SadCat1233/Laser-Space-Communication/Electrical Schemes/Station.jpeg

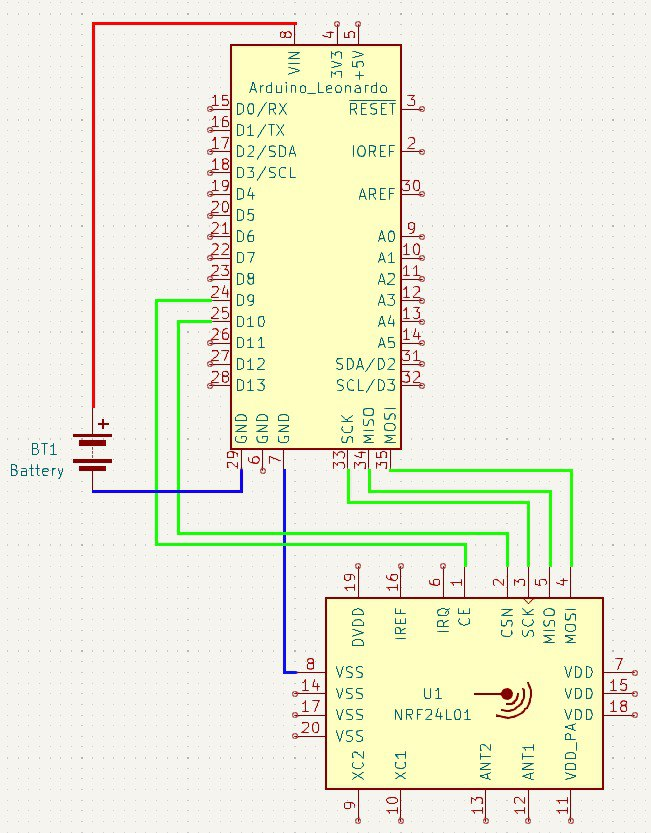
Electrical Schemes/Station.jpeg
