SadCat1233/Laser-Space-Communication/Electrical Schemes/Cubsat №2.jpeg

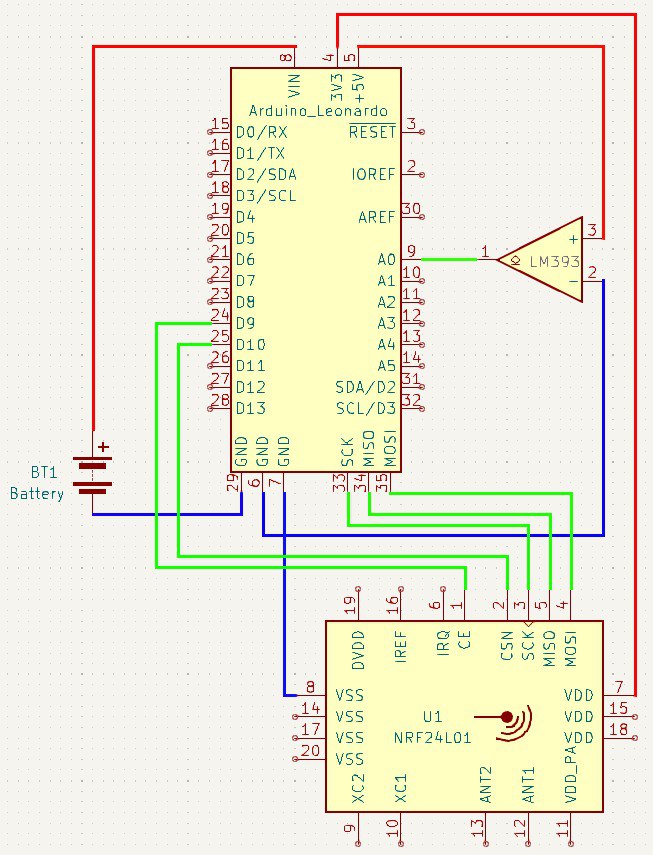
Electrical Schemes/Cubsat №2.jpeg
