SadCat1233/Laser-Space-Communication/Models/Cubsat.stl

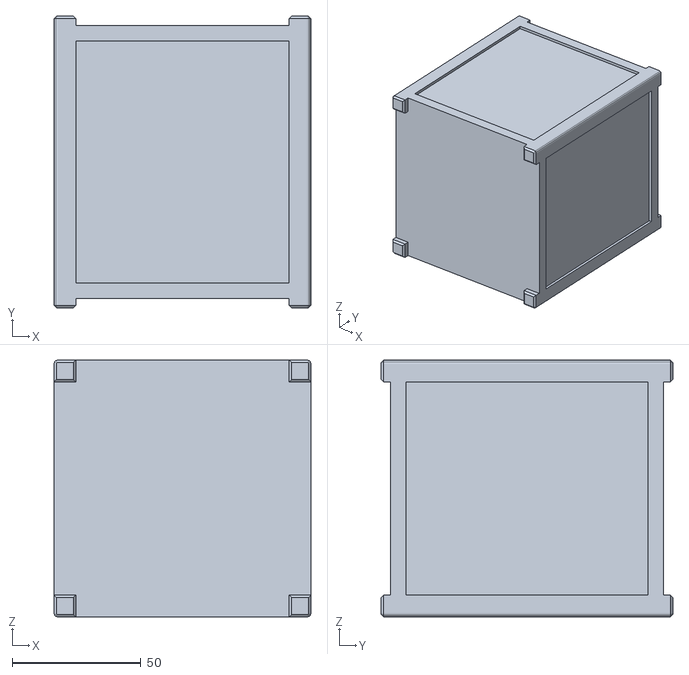
[picture p18: CAD file, 2024-02-10]
Models/Cubsat.stl
100.0 x 113.5 x 100.0
