SadCat1233/Laser-Space-Communication/Models/Рельса под 6мм.stl

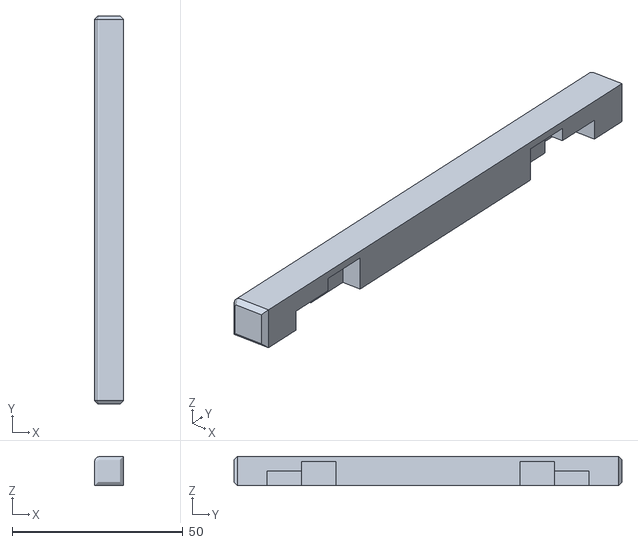
[picture p19: CAD file, 2024-02-10]
Models/Рельса под 6мм.stl
8.50 x 113.5 x 8.50
