SadCat1233/Laser-Space-Communication/Models/Крышка.dxf

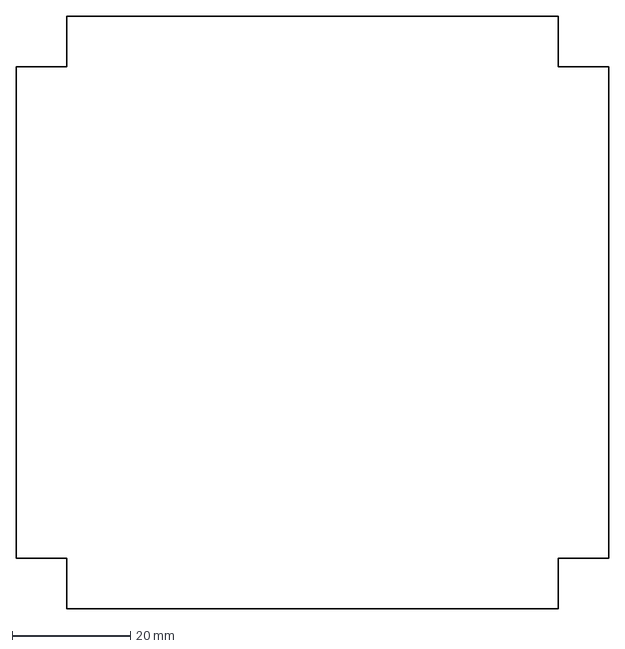
[picture p20: CAD file, 2024-02-10]
Models/Крышка.dxf
100.0 x 100.0 mm
