SadCat1233/Laser-Space-Communication/Models/Стенка.dxf

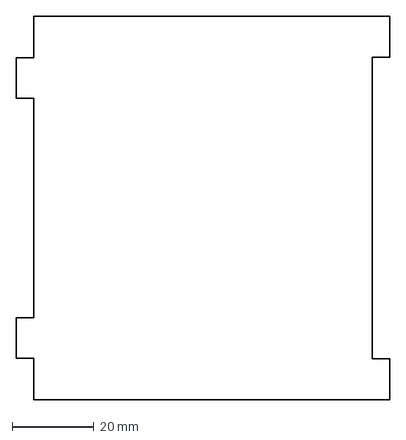
[picture p21: CAD file, 2024-02-10]
Models/Стенка.dxf
91.6 x 94.0 mm
