SadCat1233/Laser-Space-Communication/Drawings/1.pdf

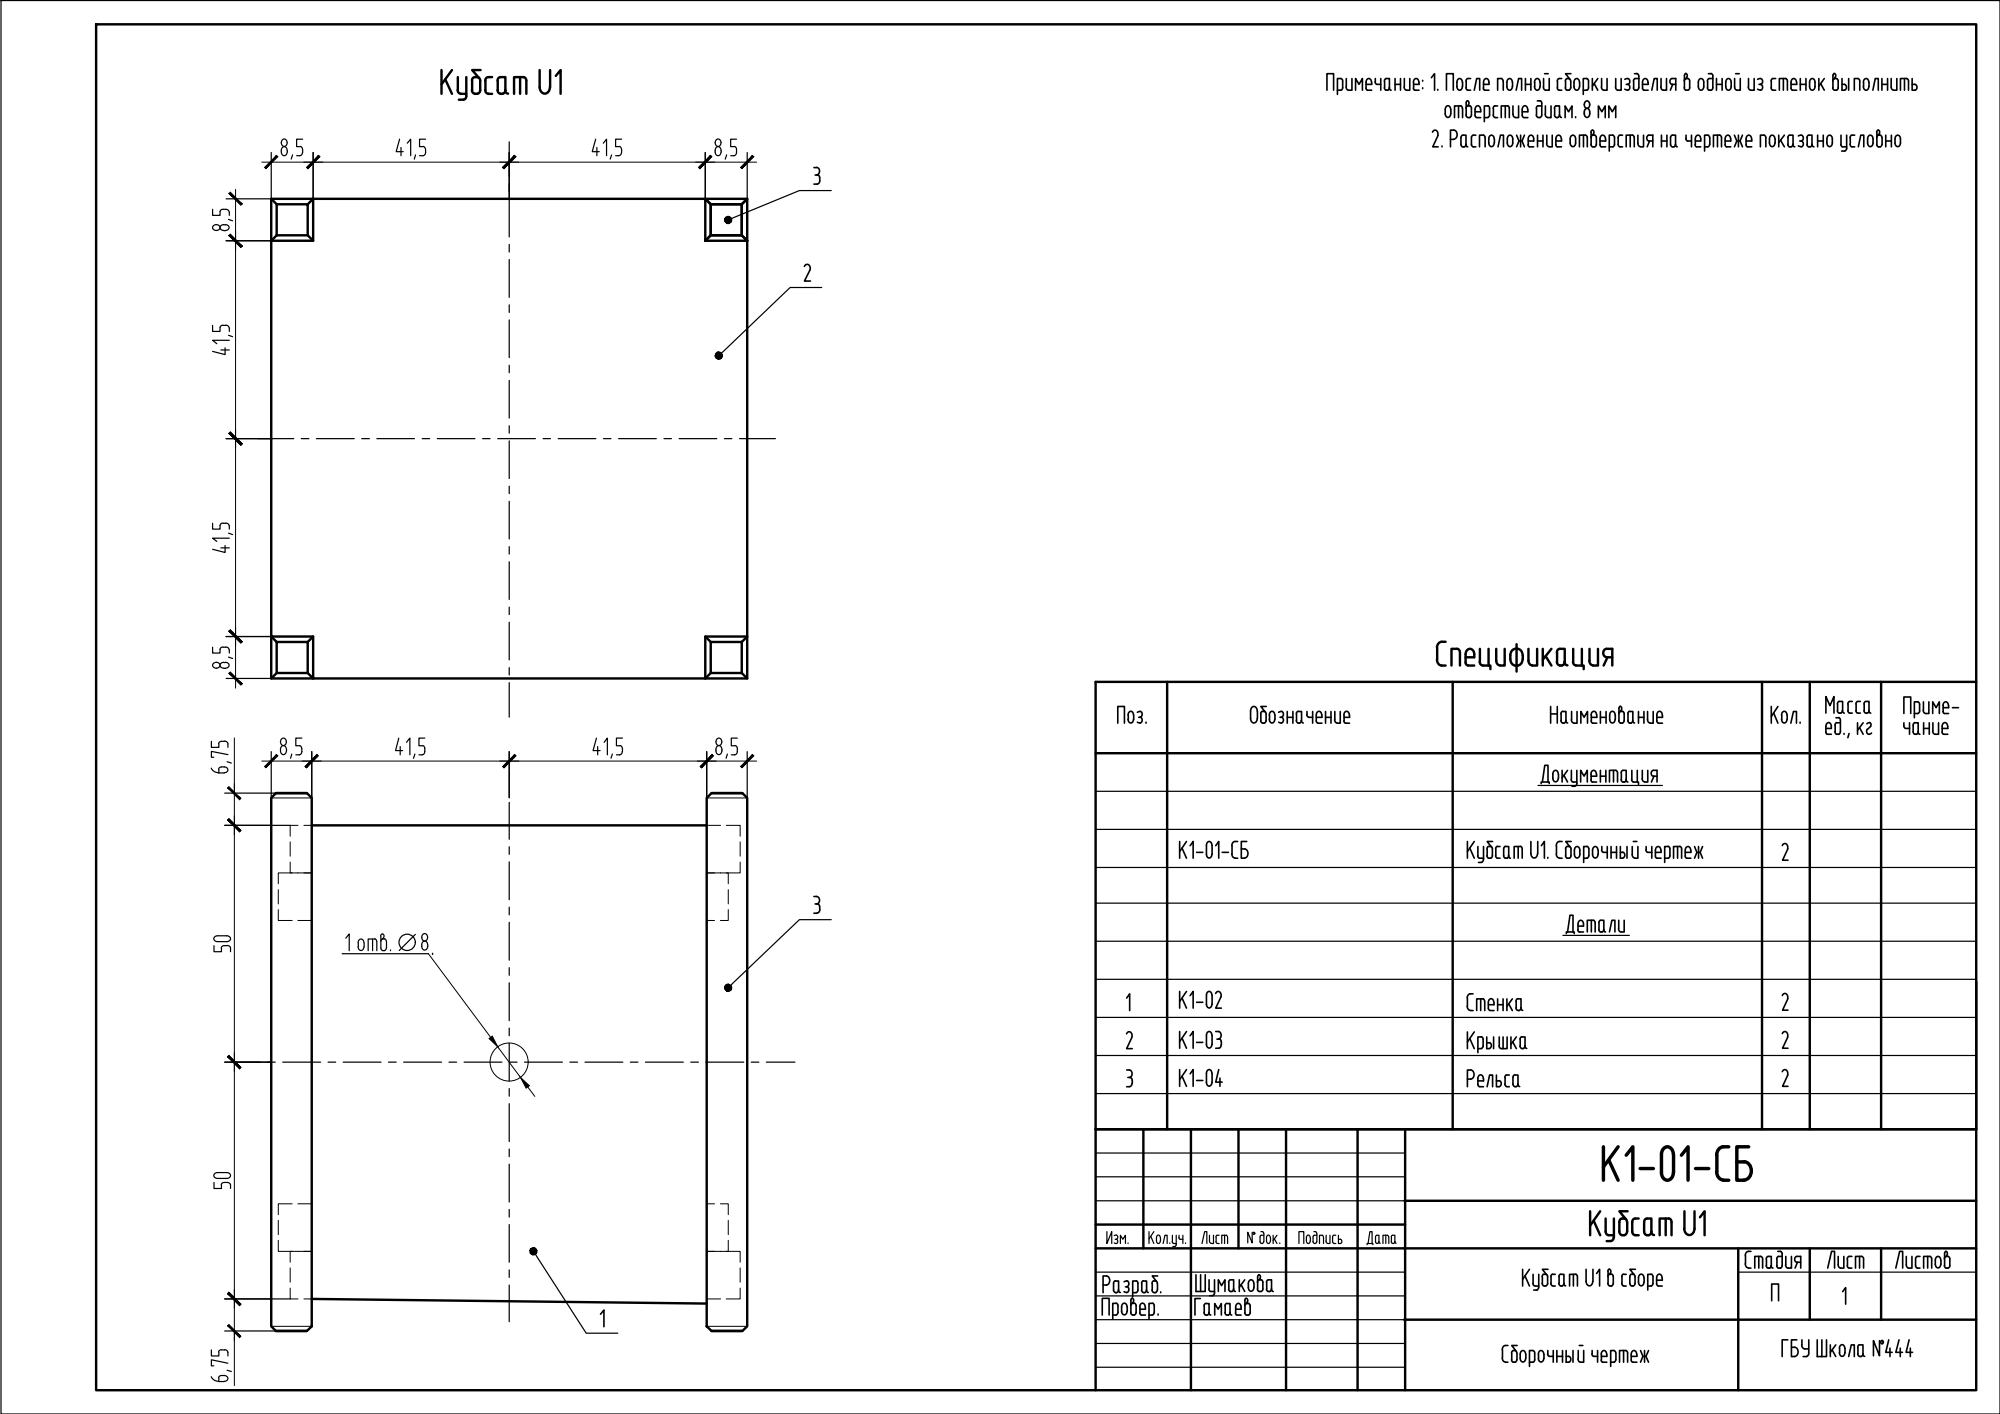
[picture p22: page 1]
