SadCat1233/Laser-Space-Communication/Drawings/2.pdf

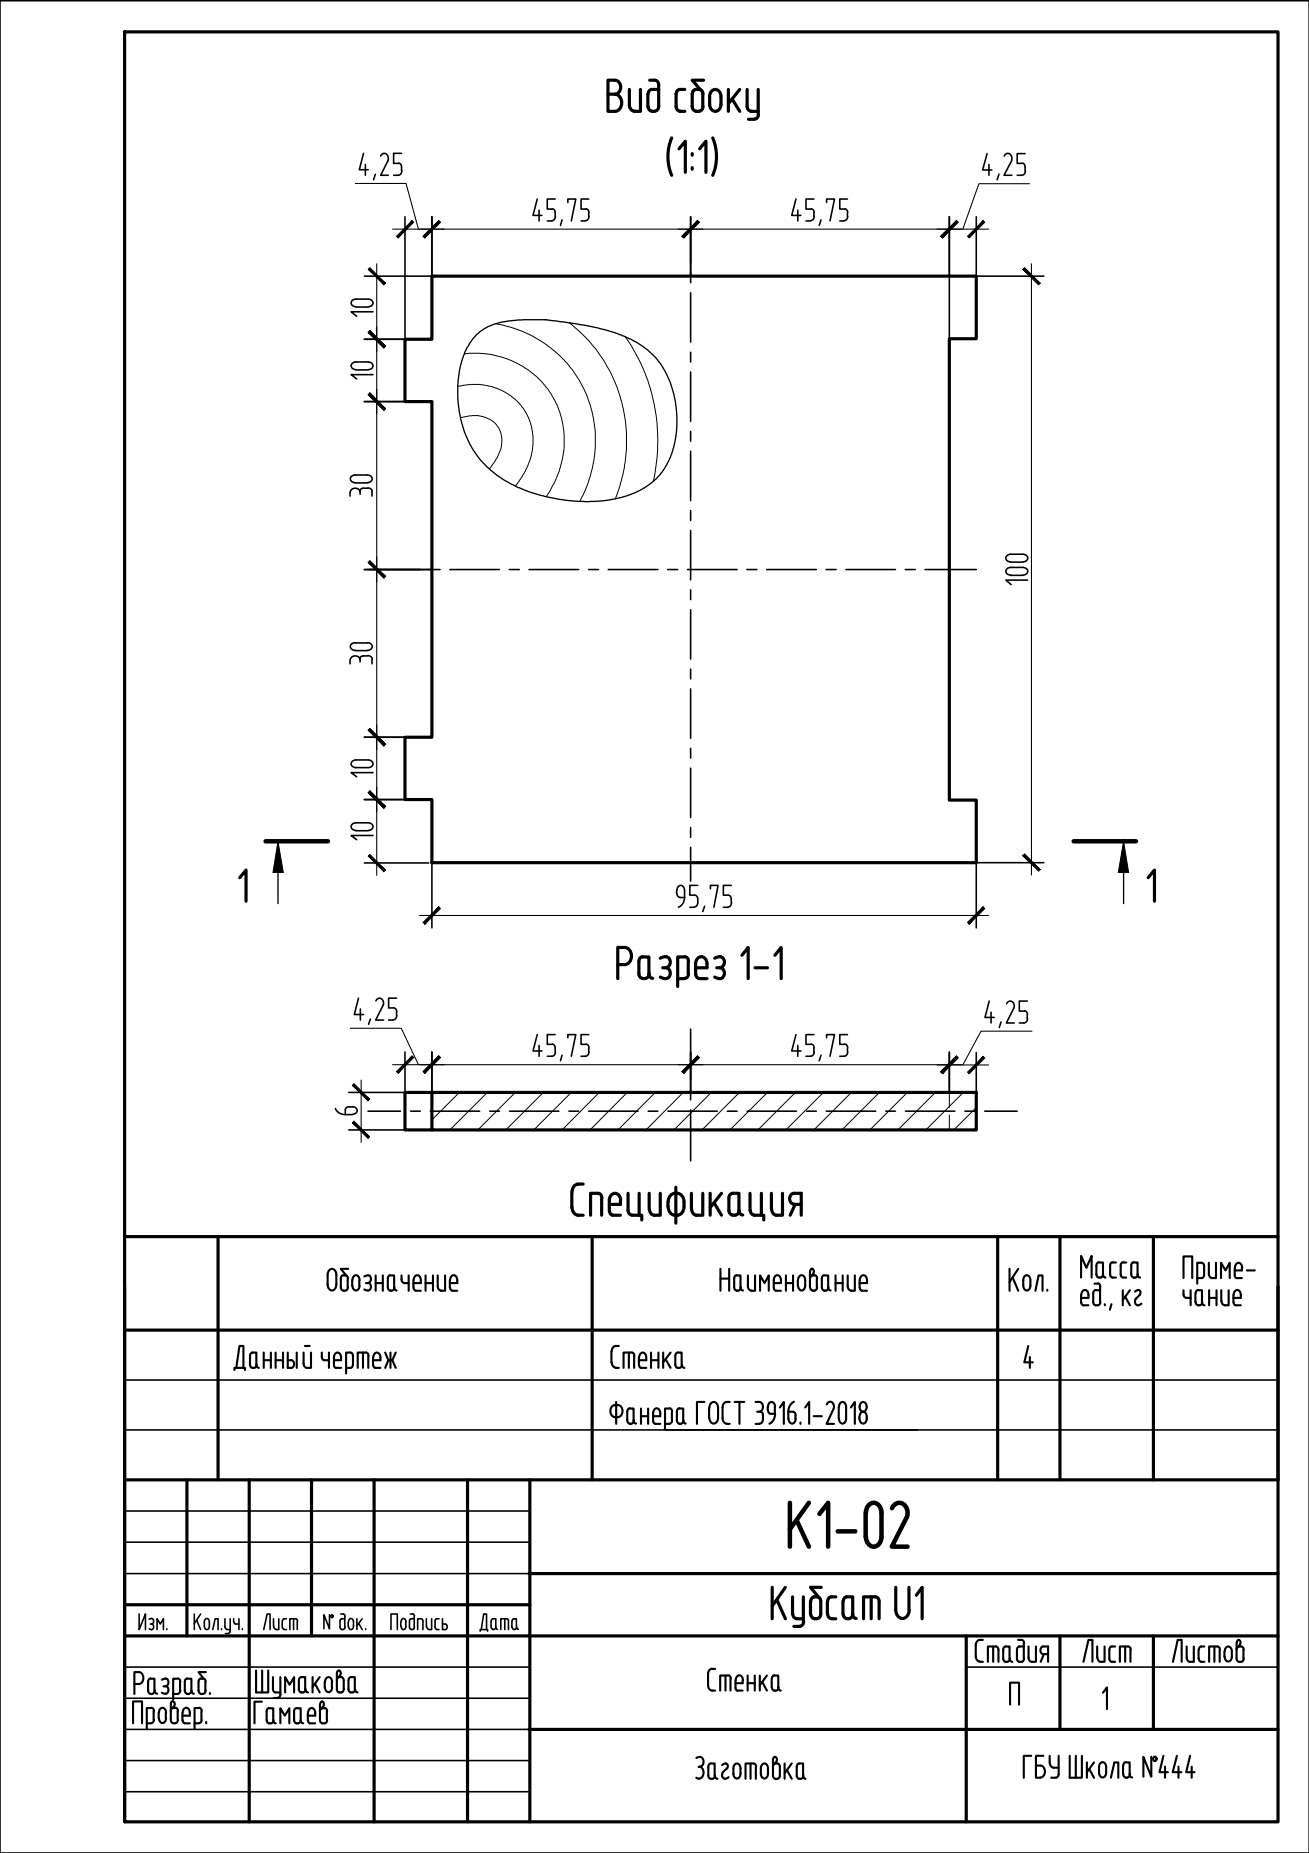
[picture p23: page 1]
