SadCat1233/Laser-Space-Communication/Drawings/3.pdf

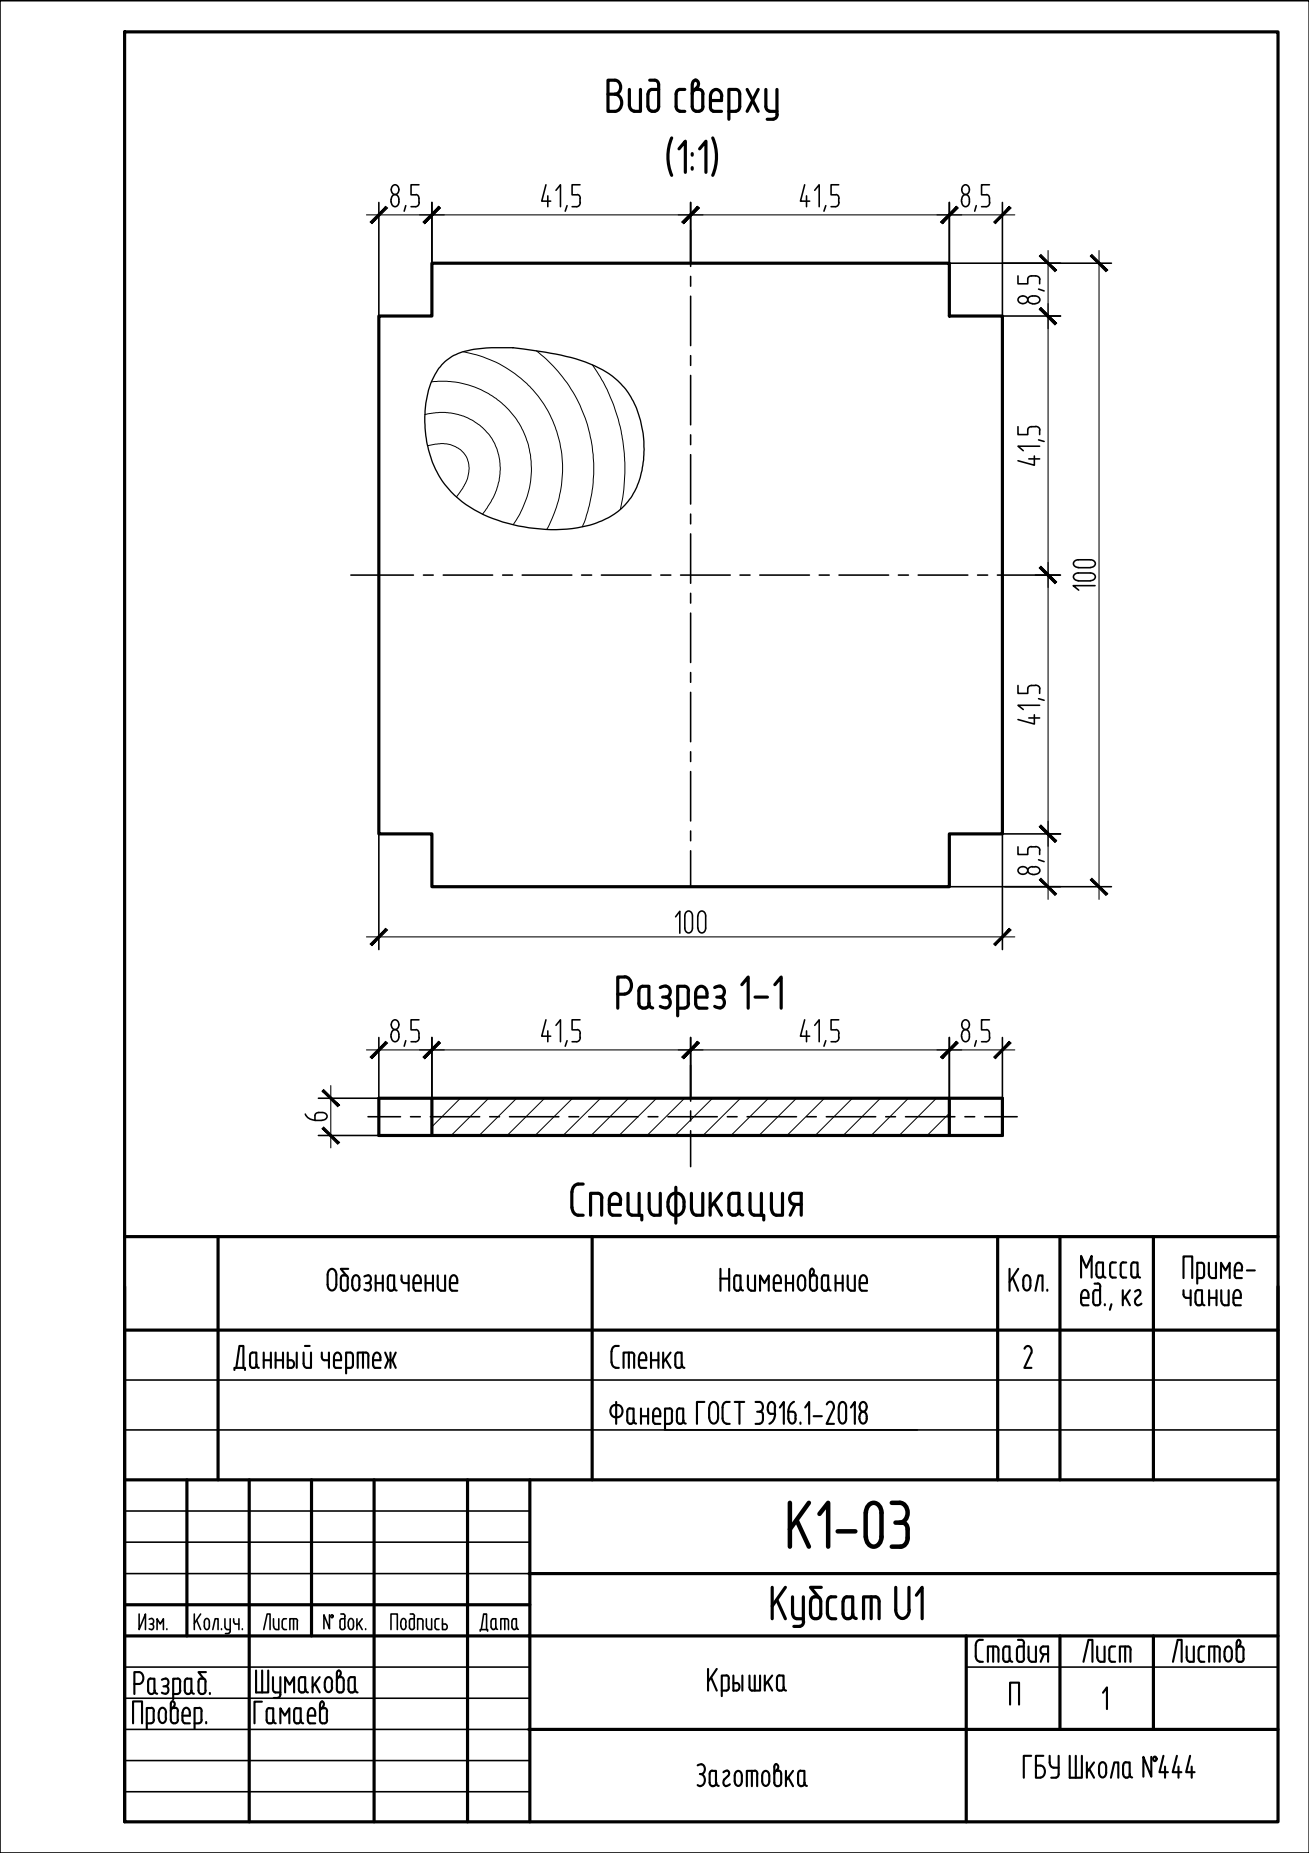
[picture p24: page 1]
