SadCat1233/Laser-Space-Communication/Drawings/4.pdf

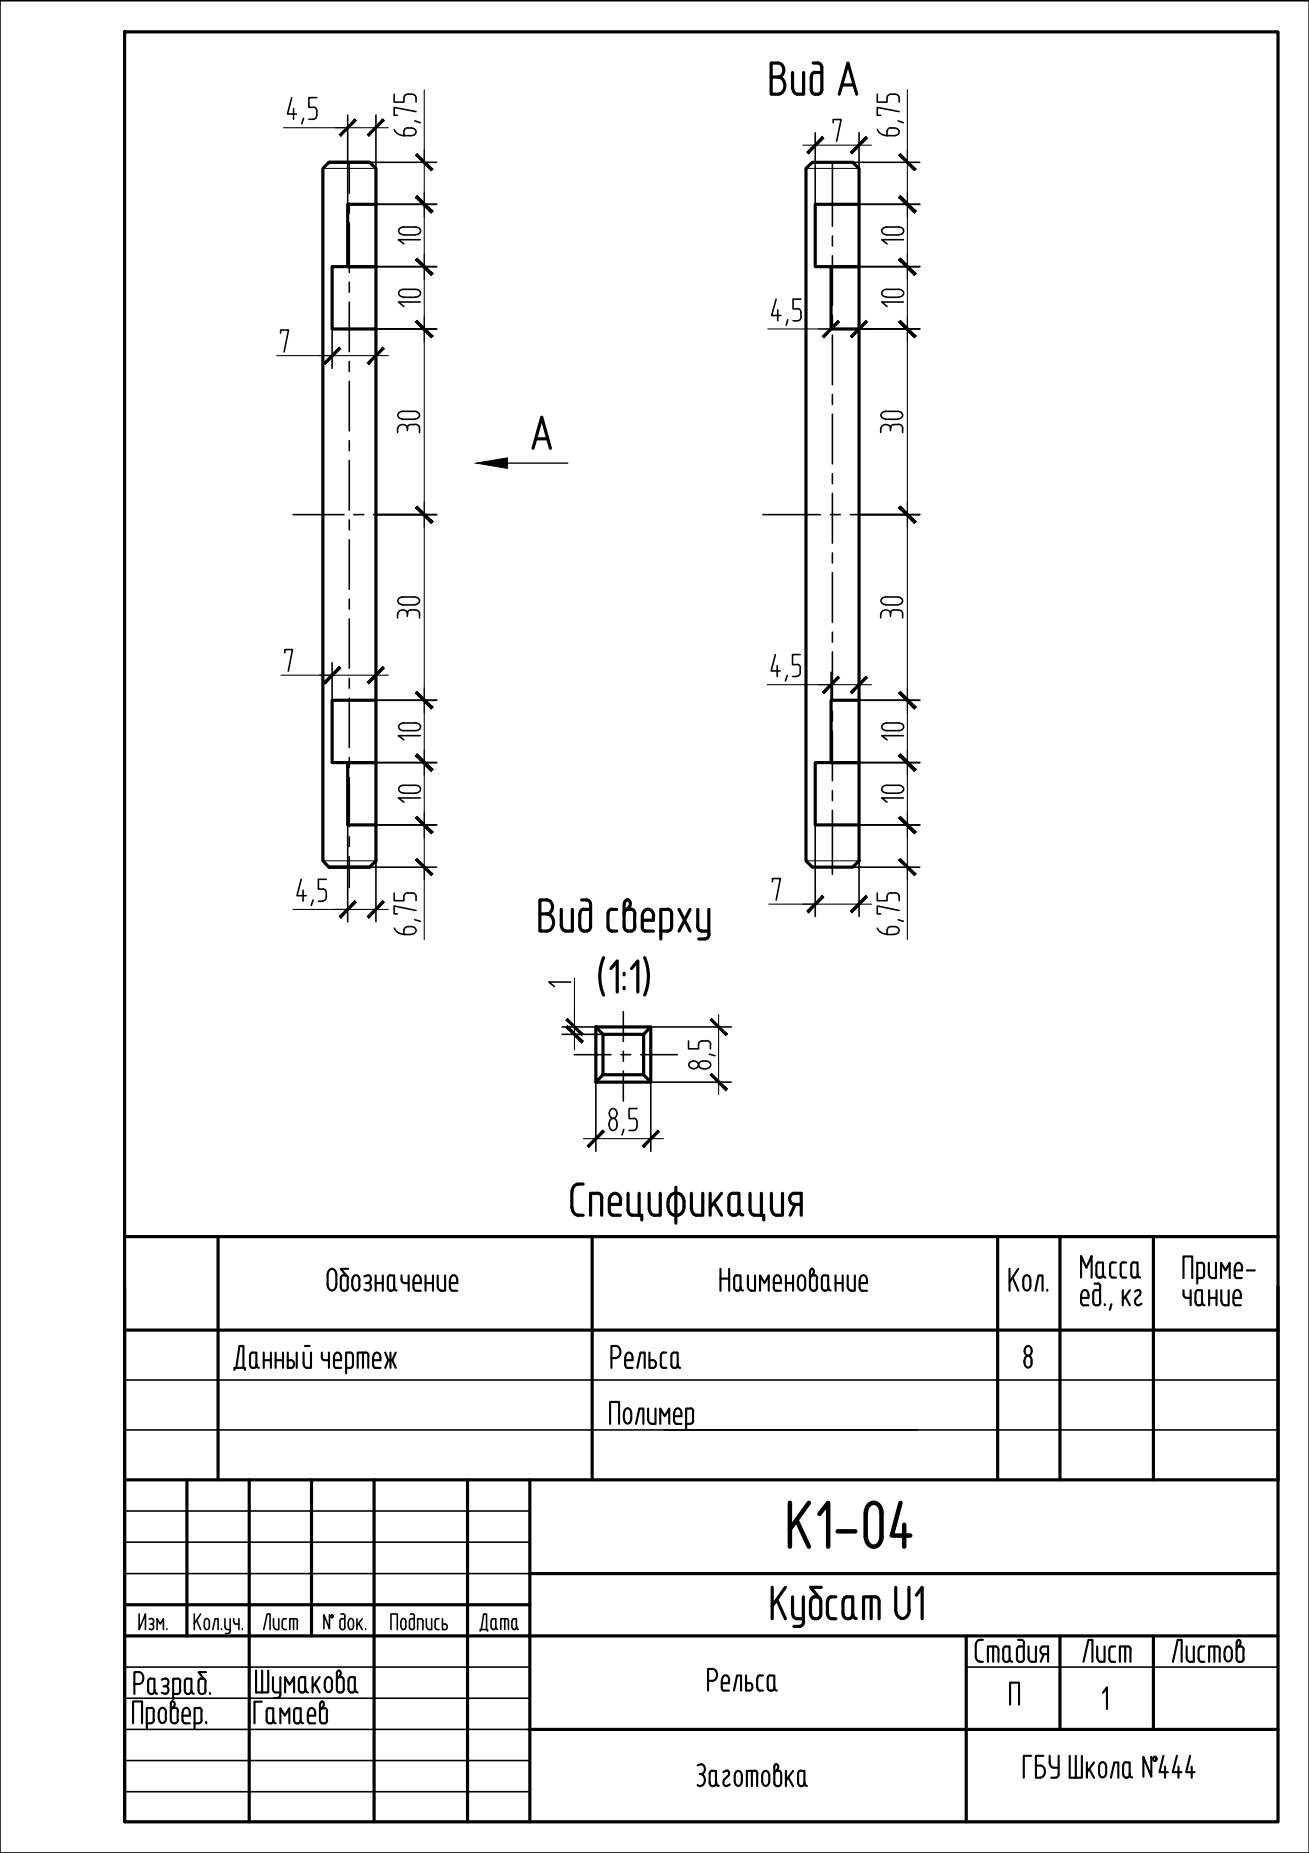
[picture p25: page 1]
