SadCat1233/Laser-Space-Communication/(commit log)

2024-02-10 v. 1.2
    [Крышка.dxf, Рельса под 6мм.stl, Стенка.dxf]
2024-02-10 v. 1.3
    [Cubsat.stl]
